claudiusmarius/TESTEUR-DE-PILES-REALISATION-PCB-DFTA248/PCB1.jpg

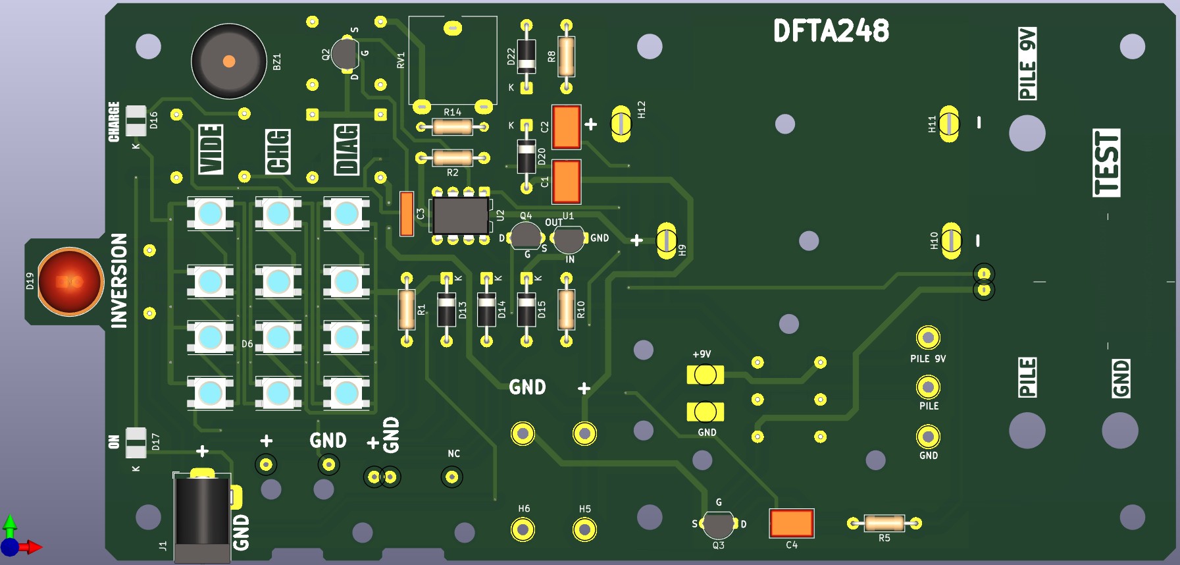
PCB1.jpg
