claudiusmarius/TESTEUR-DE-PILES-REALISATION-PCB-DFTA248/PCB2.jpg

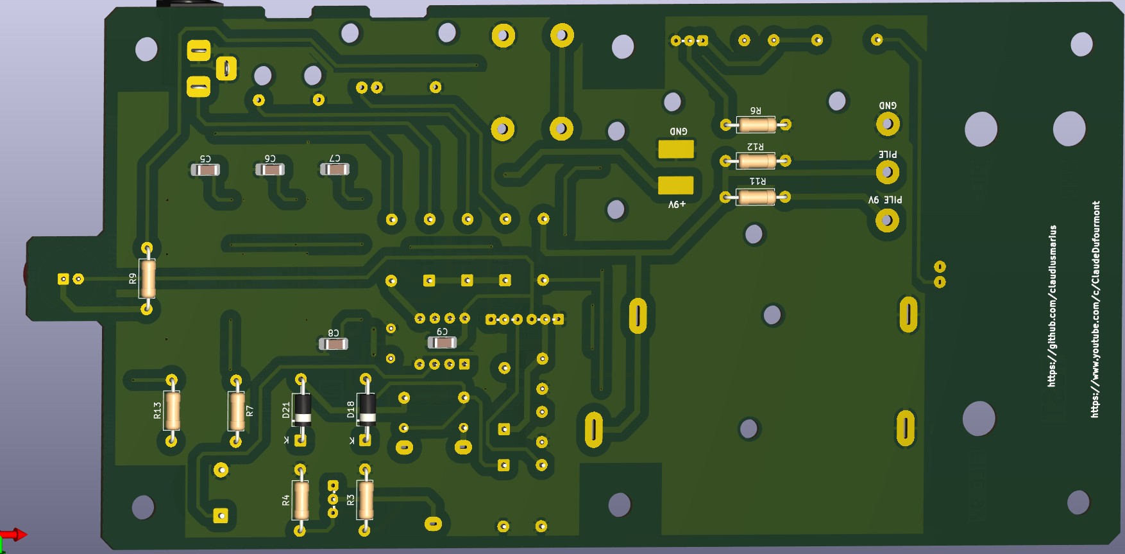
PCB2.jpg
