claudiusmarius/TESTEUR-DE-PILES-REALISATION-PCB-DFTA248/DFTA248ComposantsPDF.pdf

REF | Designation | Unité | Commentaires
BZ1 | Buzzer | | 3,3V
C1 | 1 µF | | Traversant
C2 | 1 µF | | Traversant
C3 | 100 nF | | Traversant
C4 | 1 µF | | Traversant
C5 | 100 nF | | CMS
C6 | 100 nF | | CMS
C7 | 100 nF | | CMS
C8 | 100 nF | | CMS
C9 | 100 nF | | CMS
D1 | LED Adressable | WS2812B | Contour Black
D2 | LED Adressable | WS2812B | Contour Black
D3 | LED Adressable | WS2812B | Contour Black
D4 | LED Adressable | WS2812B | Contour Black
D5 | LED Adressable | WS2812B | Contour Black
D6 | LED Adressable | WS2812B | Contour Black
D7 | LED Adressable | WS2812B | Contour Black
D8 | LED Adressable | WS2812B | Contour Black
D9 | LED Adressable | WS2812B | Contour Black
D10 | LED Adressable | WS2812B | Contour Black
D11 | LED Adressable | WS2812B | Contour Black
D12 | LED Adressable | WS2812B | Contour Black
D13 | 1N5817 | | SCHOTTKY
D14 | 1N5817 | | SCHOTTKY
D15 | 1N5817 | | SCHOTTKY
D16 | LED Jaune | LYT670 | CMS | GOTRONIC
D17 | LED Bleue | LBT670 | CMS | GOTRONIC
D18 | 1N5817 | | SCHOTTKY
D19 | LED Rouge | Diam 10mm | Traversant
D20 | 1N5817 | | SCHOTTKY
D21 | 1N5817 | | SCHOTTKY

D22 | 1N5817 | | SCHOTTKY
J1 | Barrel jack | | Adapté au bloc 5V
Q2 | Mosfet Canl N | BS170
Q3 | Mosfet Canl N | BS170
Q4 | Mosfet Canal P | BS250
R1 | 220 Ω | | 1/4 W
R2 | 1 KΩ | | 1/4 W
R3 | 180 KΩ | | 1/4 W
R4 | 2.2 Ω | | 1W
R5 | 47 KΩ | | 1/4 W
R6 | 120 KΩ | | 1/4 W
R7 | 330 Ω | | 1/4 W
R8 | 680 Ω | | 1/4 W
R9 | 0 Ω | | Strap
R10 | 56 KΩ | | 1/4 W
R11 | Non utilisé
R12 | Non utilisé
R13 | 100 Ω | | 1/4 W
R14 | 27 KΩ | | 1/4 W
RV1 | 50 KΩ
U1 | Régulateur LDO | MCP1700 3302E | Référence : 403888 | RS Particulier
U2 | ATTINY85 | | Et son socket
| Support de pile AA | | https://fr.aliexpress.com/item/1005008238740367.html?
| Support de pile AAA | | https://fr.aliexpress.com/item/1005006274732583.html
| Support de pile 9V | | https://fr.aliexpress.com/item/4000072106610.html
| Fiche bananes verticales | | https://fr.aliexpress.com/item/1005006353531551.html
| Fiches bananes horizontales | | https://fr.aliexpress.com/item/4001249395374.html
| RP-C18. 3-ST | | On en trouve partout chez Ali Express
