claudiusmarius/TESTEUR-DE-PILES-REALISATION-PCB-DFTA248/DFTA248Schema.pdf

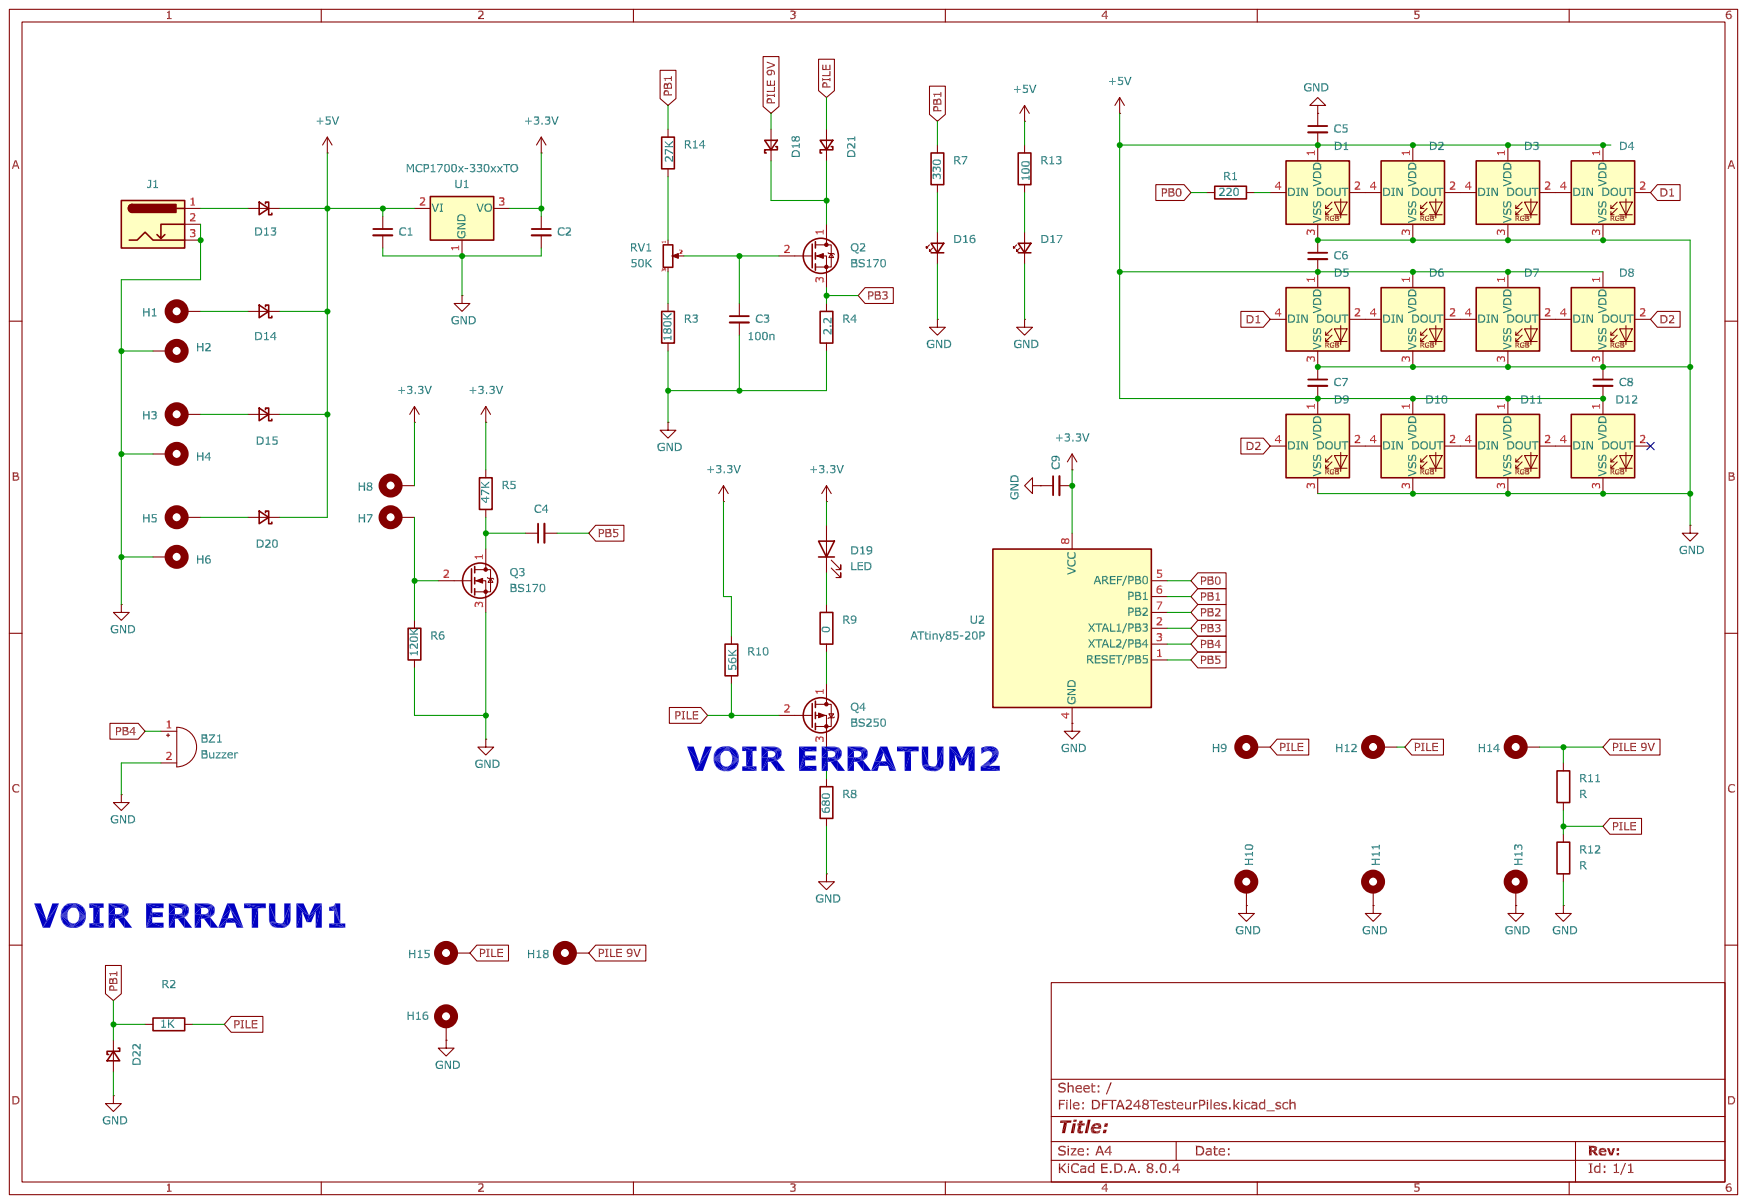
[picture p20: page 1]
